iKalyes/ChargingStation3.0/README.md

# ChargingStation3.0
Desktop Charging Station VERSION:3.0 Source Code And UI File Repo.  
桌面充电站-版本：3.0 源代码及UI文件仓库。  
项目发布地址：https://oshwhub.com/ikalyes/duo-xie-yi-zhuo-mian-chong-dian-zhan-3-0   
Copyright ©️ iKalyes 2025  
License - CERN-OHL-P v2  
任何形式的使用、研究、修改、共享和分发硬件设计及基于这些设计的产品请遵守开源协议。
