iKalyes/ChargingStation3.0/前面板图片.png

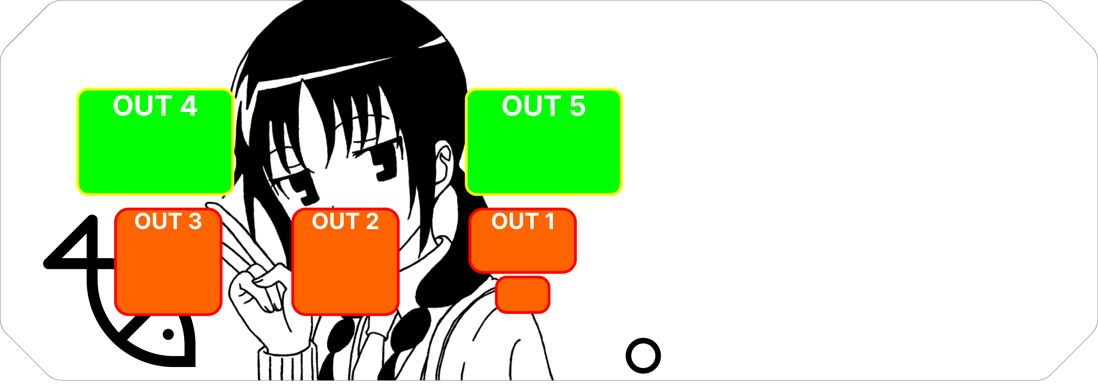
前面板图片.png
