iKalyes/ChargingStation3.0/后面板图片.png

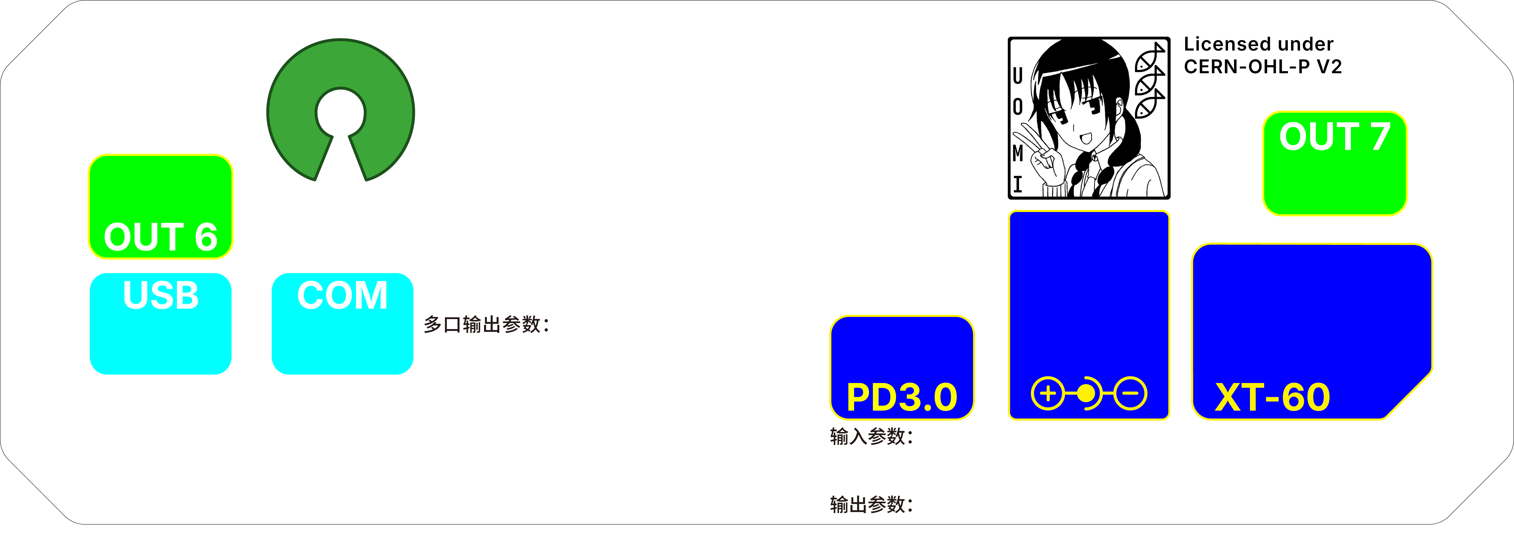
后面板图片.png
