iKalyes/ChargingStation3.0/多协议桌面充电站3.0下层BOM（价格估算）.xlsx

Sheet: bom模板
 |  |  |  | 多协议桌面充电站3.0下层BOM
 |  |  |  | Project Title：多协议桌面充电站3.0
 |  |  |  | Update Time: 2025.5.6
No. | 数量 | 名称 | 位号 | 封装 | 数值或注释 | 料号或注释 | 厂商 | 供应商 | 总价（数量） | 总价 | Check
1 | 4 | 5mΩ | R21, R22, R34, R35 | R2512 | 5mΩ | RLM25FEER005 | 大毅科技 | C185817 | 2.82(10) | 2.82
2 | 4 | 10mΩ | R19, R32, R45, R46 | RES-SMD_L6.4-W3.2-R2512 | 10mΩ | FMF25JPKR010-LH | PSA(信昌电陶) | C5144767 | 上层已计算 | 0
3 | 2 | 20mΩ | R17, R72 | RES-SMD_L6.4-W3.2_LR2512D-3W-1MR | 20mΩ | HoYLR2512-3W-20mR-1% | Milliohm(毫欧) | C5375467 | 3.16(10) | 3.16
4 | 11 | 2Ω | R25, R26, R27, R28, R29, R38, R39, R40, R41, R42, R44 | R0603 | 2Ω | 0603WAF200KT5E | UNI-ROYAL(厚声) | C22977 | 上层已计算 | 0
5 | 15 | 10Ω | R11, R15, R16, R18, R20, R23, R24, R30, R31, R33, R36, R37, R43, R47, R48 | R0603 | 10Ω | 0603WAF100JT5E | UNI-ROYAL(厚声) | C22859 | 0.13(20) | 0.13
6 | 2 | 20Ω | R2, R3 | R0603 | 20Ω | 0603WAF200JT5E | UNI-ROYAL(厚声) | C22950 | 0.69(100) | 0.69
7 | 2 | 1kΩ | R63, R76 | R0603 | 1kΩ | 0603WAF1001T5E | UNI-ROYAL(厚声) | C21190 | 上层已计算 | 0
8 | 11 | 4.7kΩ | R9, R10, R12, R13, R14, R49, R50, R51, R52, R74, R75 | R0603 | 4.7kΩ | 0603WAF4701T5E | UNI-ROYAL(厚声) | C23162 | 0.14(20) | 0.14
9 | 6 | 5.1kΩ | R1, R4, R61, R62, R67, R68 | R0603 | 5.1kΩ | 0603WAF5101T5E | UNI-ROYAL(厚声) | C23186 | 0.66(100) | 0.66
10 | 4 | 10kΩ | R8, R54, R56, R73，R77, R78, R79 | R0603 | 10kΩ | 0603WAF1002T5E | UNI-ROYAL(厚声) | C25804 | 上层已计算 | 0
11 | 1 | 33.2kΩ | R53 | R0603 | 33.2kΩ | FRC0603F3322TS | FOJAN | C2933200 | 0.60(100) | 0.6
12 | 2 | 100kΩ | R5, R57 | R0603 | 100kΩ | 0603WAF1003T5E | UNI-ROYAL(厚声) | C25803 | 上层已计算 | 0
13 | 1 | 200kΩ | R60 | R0603 | 200kΩ | 0603WAF2003T5E | UNI-ROYAL(厚声) | C25811 | 0.70(100) | 0.7
15 | 1 | 1nF | C66 | C0603 | 1nF | CL10B102KB8NNNC | SAMSUNG(三星) | C1588 | 上层已计算 | 0
16 | 4 | 3.3nF | C43, C44, C57, C58 | C0603 | 3.3nF | CL10B332KB8NNNC | SAMSUNG(三星) | C1613 | 3.42(100) | 3.42
17 | 7 | 100nF | C21, C23, C30, C32, C46, C69, C71，C74, C77, C79, C85, C86, C87，C25, C39, C40, C53, C54, C59, C62, C63, C83, C84 | C0603 | 100nF | CL10B104KB8NNNC | SAMSUNG(三星) | C1591 | 上层已计算 | 0
18 | 15 | 1uF | C12, C31, C33, C34, C35, C45, C47, C48, C49，C9, C10, C11, C22, C70, C80 | C0603 | 1uF | CL10A105KB8NNNC | SAMSUNG(三星) | C15849 | 上层已计算 | 0
19 | 5 | 2.2uF | C41, C42, C55, C56, C82 | C0603 | 2.2uF | CL10A225KO8NNNC | SAMSUNG(三星) | C23630 | 3.88(100) | 3.88
20 | 2 | 10uF | C72, C73 | C0805 | 10uF | CL21A106KAYNNNE | SAMSUNG(三星) | C15850 | 1.41(20) | 1.41
21 | 2 | 22uF | C75, C76 | C0805 | 22uF | CL21A226MAQNNNE | SAMSUNG(三星) | C45783 | 1.55(10) | 1.55
22 | 4 | 10uF | C36, C50, C64, C65 | C1206 | 10uF - 耐压35V及以上 | CL31A106KBHNNNE | SAMSUNG(三星) | C13585 | 上层已计算 | 0
23 | 3 | 22uF | C61, C67, C68 | C1206 | 22uF - 耐压25V及以上 | CL31A226KAHNNNE | SAMSUNG(三星) | C12891 | 上层已计算 | 0
24 | 4 | 100uF | C17, C18, C37, C51 | C1210 | 100uF - MLCC | 耐压35V及以上 |  | 淘宝 | 上层已计算 | 0
25 | 5 | 100uF | U10, U12, U14, U16, U19 | CAP-SMD_BD6.3-L6.6-W6.6-LS7.3-FD | 100uF - 固态电容 | 耐压35V及以上 |  | 淘宝 | 上层已计算 | 0
26 | 1 | 220uF | C60 | CAP-SMD_BD8.0-L8.3-W8.3-LS8.9-FD | 220uF - 固态电容 | 耐压35V及以上 |  | 淘宝 | 上层已计算 | 0
27 | 2 | 470uF | U24, U25 | CAP-SMD_BD10.0-L10.3-W10.3-LS11.0-FD | 470uF - 固态电容 | 耐压35V及以上 |  | 淘宝 | 5.3(5) | 5.3
29 | 1 | 2.2uH | L3 | IND-SMD_L4.4-W4.2 | 2.2uH | SLO0420H2R2MTT | Sunltech(韩国顺磁) | C207828 | 4.32(5) | 4.32
30 | 1 | 10uH | L4 | IND-SMD_L11.5-W10.0_FXL1040 | 10uH | FXL1040-100-M | cjiang(长江微电) | C475915 | 上层已计算 | 0
31 | 2 | 10uH | U13, U17 | IND-SMD_L13.8-W12.8 | 10uH | CYA1265-10UH |  | 淘宝 | 7.25(5) | 7.25
32 | 1 | 68uH | L1 | IND-SMD_L7.1-W6.6 | 68uH | SMMS0650-680M | SXN(顺翔诺) | C2894721 | 5.31(5) | 5.31
34 | 1 | ZMM3V3 | D3 | LL-34_L3.5-W1.5-LS3.5-FD |  | ZMM3V3 |  | 上层已计算 | 上层已计算 | 0
35 | 1 | SS24F | D1 | SMAF_L3.5-W2.6-LS4.7-RD |  | SS24F | Hottech(合科泰) | C190803 | 0.71(5) | 0.71
36 | 1 | SMF30A | D4 | SOD-123FL_L2.7-W1.8-LS3.8-RD |  | SMF30A | 宏迦橙 | C19077518 | 3.01(20) | 3.01
37 | 1 | SS26 | D2 | SMA_L4.4-W2.8-LS5.4-RD |  | SS26 | BORN(伯恩半导体) | C306851 | 2.68(10) | 2.68
39 | 2 | S8050 J3Y | Q13, Q14 | SOT-23-3_L3.0-W1.7-P0.95-LS2.9-BR |  | S8050 J3Y | CJ(江苏长电/长晶) | C2146 | 4.34(50) | 4.34
40 | 1 | 2N7002 | Q22 | SOT-23-3_L2.9-W1.3-P1.90-LS2.4-BR |  | 2N7002 | CJ(江苏长电/长晶) | C8545 | 上层已计算 | 0
41 | 3 | DTC143ZCA | Q2, Q3, Q16 | SOT-23-3_L2.9-W1.3-P1.90-LS2.4-BR |  | DTC143ZCA | CJ(江苏长电/长晶) | C15236 | 上层已计算 | 0
42 | 2 | NCE30P30K | Q1, Q15 | TO-252-2_L6.6-W6.1-P4.57-LS9.9-TL-CW |  | NCE30P30K | NCE(无锡新洁能) | C130106 | 上层已计算 | 0
43 | 10 | AP75N03NF | Q4, Q5, Q6, Q7, Q8, Q9, Q10, Q11, Q12, Q21 | PDFN-8_L5.8-W4.9-P1.27-LS6.1-BL | 参数更好或相同均可 | AP75N03NF | APM | 淘宝 | 6(10) | 6
45 | 1 | LMV321-TR | U8 | SOT-23-5_L3.0-W1.7-P0.95-LS2.8-BR |  | LMV321-TR | Gainsil(聚洵) | C362273 | 上层已计算 | 0
46 | 1 | CH221K | Q20 | SOT-23-6_L2.9-W1.6-P0.95-LS2.8-BL-2 |  | CH221K |  | 淘宝 | 7.00(5) | 7
47 | 1 | XL1509-5.0E1 | U4 | SOIC-8_L5.0-W4.0-P1.27-LS6.0-BL |  | XL1509-5.0E1 | XLSEMI(芯龙) | C61063 | 7.65(5) | 7.65
48 | 1 | MX74610T | U26 | SOT-23-6_L2.9-W1.6-P0.95-LS2.8-BL-1 |  | MX74610T |  | 淘宝 | 6.8(5) | 6.8
49 | 1 | INA219AIDCNR | U6 | SOT-23-8_L3.0-W1.7-P0.65-LS2.8-BR |  | INA219AIDCNR | TI(德州仪器) | C87469 | 4.54(1) | 4.54
50 | 1 | CH340K | U21 | ESOP-10_L4.9-W3.9-P1.00-LS6.2-BL-EP |  | CH340K | WCH(南京沁恒) | C968586 | 4.11(1) | 4.11
51 | 1 | INA3221AIRGVR | U7 | QFN-16_L4.0-W4.0-P0.65-TL-EP2.2 |  | INA3221AIRGVR | TI(德州仪器) | C181255 | 6.5(1) | 6.5
52 | 2 | IP6557_C | U11, U15 | QFN-40_L5.0-W5.0-P0.40-BL-EP3.7 |  | IP6557_C |  | 淘宝 | 13(2) | 13
53 | 1 | TPS563201DDCR | U22 | SOT-23-6_L2.9-W1.6-P0.95-LS2.8-BL |  | TPS563201DDCR | TI(德州仪器) | C116592 | 2.58(5) | 2.58
54 | 1 | IP6538-AC | U18 | QFN-32_L5.0-W5.0-P0.50-TL-EP3.4 |  | IP6538-AC | INJOINIC(英集芯) | 淘宝 | 4(1) | 4
55 | 1 | ESP32-S3-WROOM-1-N8R2 | U20 | WIRELM-SMD_ESP32-S3-WROOM-1 | FLASH大于等于8MB均可 | ESP32-S3-WROOM-1-N8R2 |  | 淘宝 | 14.8(1) | 14.8
57 | 2 | TSA002A3512A02 | SW1, SW2 | SW-SMD_BZCN_TSA002A35XXX |  | TSA002A3512A02 | BZCN(博众电气) | C2888932 | 2.35(20) | 2.35
58 | 2 | ZX-XH2.54-2PLT | U27, U29 | CONN-SMD_2P-P2.50_HCTL_HC-XH-2ALT |  | ZX-XH2.54-2PLT | Megastar(兆星) | C7429680 | 上层已计算 | 0
59 | 2 | 0451010.MRL | U2, U3 | FUSE-SMD_L6.1-W2.7 |  | 0451010.MRL | Littelfuse(美国力特) | C44479 | 3.47(5) | 3.47
60 | 1 | AFC07-S12ECA-00 | FPC2 | FPC-SMD_12P-P0.50_AFC07-S12ECA-00 | 12Pin 0.5mm 上接 | AFC07-S12ECA-00 | JS(钜硕电子) | C262585 | 3.53(5) | 3.53
61 | 1 | AFA07-S12FCA-00 | FPC1 | FPC-SMD_P1.00-12P_LCS-XJ-H2.5 |  | AFA07-S12FCA-00 | JS(钜硕电子) | C262718 | 上层已计算 | 0
62 | 3 | XL-4020RGBC-WS2812B | LED1, LED2, LED3 | LED-SMD_4P-L4.0-W1.7_XL-4020RGBC-WS2812B |  | XL-4020RGBC-WS2812B | XINGLIGHT(成兴光) | C3647024 | 3.91(5) | 3.91
63 | 1 | LY-K3-01B-04 | U28 | SW-SMD_QS-301-AGS5P |  | LY-K3-01B-04 | 温州一键（淘宝） | 淘宝 | 6.4(10) | 6.4
64 | 5 | U262-161N-4BVC11 | USB1, USB2, USB3, USB4,USB5, USB6 | USB-3.1-SMD_U262-161N-4BVC11 |  |  | 汉德电子连接器（淘宝） | 淘宝 | 上层已计算 | 0
65 | 1 | DC007B-2.5-J | U30 | DC-IN-TH_HX-DC007B-2.5 | 5525和5521均可 | DC007B-2.5-J | SHOU HAN(首韩) | C17701686 | 2.67(1) | 2.67
66 | 1 | XT60PW-M | CN1 | CONN-TH_XT60PW-M |  | XT60PW-M | AMASS(艾迈斯) | C98732 | 3.79(1) | 3.79
67 | 1 | 1.3寸LCD液晶屏幕（ST7789） | 12PIN 插接 |  |  |  |  | 淘宝 | 5.4(1) | 5.4
68 | 1 | 铝型材外壳 | 104*36*80（毫米） |  | 嘉立创定制铝型材外壳 | 阳极氧化+UV打印 |  | 嘉立创 | 101.9(2) | 101.9
69 | 1 | NTC100K B3950 |  |  |  |  |  | 淘宝 | 1.31（1） | 1.31
 |  |  |  |  |  |  |  |  |  | 263.79

Sheet: Field汇总
Project Title | 多协议桌面充电站3.0
Borard Title | 下层
Schematic Title | 下层
PCB Title
Variant Name
Total Quantity | 198
Report Time | 22:22:33
Report Date | 2025年4月6日
Report Date&Time | 2025年4月6日 22:22:33
File Name | BOM_下层_下层_2025-04-06
Filter Option | Add into BOM:no;
