iKalyes/ChargingStation3.0/多协议桌面充电站3.0上层BOM（价格估算）.xlsx

Sheet: bom模板
 |  |  |  | 多协议桌面充电站3.0上层BOM
 |  |  |  | Project Title：多协议桌面充电站3.0
No. | Quantity | Comment | Designator | Footprint | Value | Manufacturer Part | Manufacturer | Supplier Part
1 | 4 | AP75N03NF | Q1, Q4, Q6, Q7 | PDFN-8_L5.8-W4.9-P1.27-LS6.1-BL |  | AP75N03NF | APM | 淘宝 | 2.4(4) | 2.4
2 | 4 | 10kΩ | R8, R16, R17, R18, R12 | R0603 | 10kΩ | 0603WAF1002T5E | UNI-ROYAL(厚声) | C25804 | 0.63(100) | 0.63
3 | 1 | 100kΩ | R6 | R0603 | 100kΩ | 0603WAF1003T5E | UNI-ROYAL(厚声) | C25803 | 0.26(50) | 0.26
4 | 3 | 1kΩ | R7, R11, R19 | R0603 | 1kΩ | 0603WAF1001T5E | UNI-ROYAL(厚声) | C21190 | 0.65(100) | 0.65
5 | 2 | 2Ω | R1, R20 | R0603 | 2Ω | 0603WAF200KT5E | UNI-ROYAL(厚声) | C22977 | 1(100) | 1
6 | 14 | 100nF | C7, C8, C10, C12, C16, C18, C36, C38, C39, C40, C47, C49, C51, C56 | C0603 | 100nF | CC0603KRX7R9BB104 | YAGEO(国巨) | C14663 | 1.56(100) | 1.56
7 | 2 | 1nF | C1, C41 | C0603 | 1nF | CL10B102KB8NNNC | SAMSUNG(三星) | C1588 | 1.93(100) | 1.93
8 | 2 | 1uF | C35, C37 | C0603 | 1uF | CL10A105KB8NNNC | SAMSUNG(三星) | C15849 | 1.68(50) | 1.68
9 | 4 | 10uF | C2, C3, C42, C43 | C1206 | 10uF 耐压35V及以上 | CL31A106KBHNNNE | SAMSUNG(三星) | C13585 | 2.24(10) | 2.24
10 | 10 | 22uF | C5, C6, C14, C15, C17, C45, C46, C48, C50, C57 | C1206 | 22uF 耐压25V及以上 | CL31A226KAHNNNE | SAMSUNG(三星) | C12891 | 6.99(20) | 6.99
11 | 8 | 100uF | C19, C20, C21, C22, C52, C53, C54, C55 | C1210 | 100uF | 耐压35V及以上 |  | 淘宝 | 4.2(15) | 4.2
12 | 2 | 100uF | U2, U10 | CAP-SMD_BD6.3-L6.6-W6.6-LS7.3-FD | 100uF - 固态电容 | 耐压35V及以上 |  | 淘宝 | 6.9(15) | 6.9
13 | 2 | 220uF | C4, C44 | CAP-SMD_BD8.0-L8.3-W8.3-LS8.9-FD | 220uF - 固态电容 | 耐压35V及以上 |  | 淘宝 | 10.35(15) | 10.35
14 | 1 | ZMM3V3 | D3 | LL-34_L3.5-W1.5-LS3.5-FD |  | ZMM3V3 | 萨科微(Slkor) | C707189 | 3.03(50) | 3.03
15 | 1 | 2N7002 | Q5 | SOT-23-3_L2.9-W1.3-P1.90-LS2.4-BR |  | 2N7002 | CJ(江苏长电/长晶) | C8545 | 4.71(50 | 4.71
16 | 1 | DTC143ZCA | Q3 | SOT-23-3_L2.9-W1.3-P1.90-LS2.4-BR |  | DTC143ZCA | CJ(江苏长电/长晶) | C15236 | 2.34(20) | 2.34
17 | 1 | ME6212C33M5G | U3 | SOT-23-5_L3.0-W1.7-P0.95-LS2.8-BL |  | ME6212C33M5G | MICRONE(南京微盟) | C81233 | 2.36(10) | 2.36
18 | 4 | 10mΩ | R2, R10, R21, R22 | RES-SMD_L6.4-W3.2-R2512 | 10mΩ | FMF25JPKR010-LH | PSA(信昌电陶) | C5144767 | 3.15(10) | 3.15
19 | 2 | LMV321-TR | U8, U9 | SOT-23-5_L3.0-W1.7-P0.95-LS2.8-BR |  | LMV321-TR | Gainsil(聚洵) | C362273 | 10(4.17) | 10
20 | 1 | ZX-XH2.54-2PLT | U29 | CONN-SMD_2P-P2.50_HCTL_HC-XH-2ALT |  | ZX-XH2.54-2PLT | Megastar(兆星) | C7429680 | 1.89(5) | 1.89
21 | 1 | AFA07-S12FCA-00 | FPC1 | FPC-SMD_P1.00-12P_LCS-XJ-H2.5 |  | AFA07-S12FCA-00 | JS(钜硕电子) | C262718 | 3.73(5) | 3.73
22 | 1 | NCE30P30K | Q2 | TO-252-2_L6.6-W6.1-P4.57-LS9.9-TL-CW |  | NCE30P30K | NCE(无锡新洁能) | C130106 | 6.83(5) | 6.83
23 | 2 | 919-152A1072D10400 | USB1, USB3 | USB-A-TH_919-152A1072D10400 |  | 前脚卧插 | 汉德电子连接器 | 淘宝 | 2.8(10) | 2.8
24 | 2 | 10uH | L1, L2 | IND-SMD_L11.5-W10.0_FXL1040 | 10uH | FXL1040-100-M | cjiang(长江微电) | C475915 | 6.43(5) | 6.43
25 | 2 | U262-161N-4BVC11 | USB2, USB4 | USB-3.1-SMD_U262-161N-4BVC11 |  |  | 汉德电子连接器 | 淘宝 | 6.7(10) | 6.7
26 | 2 | IP6538-AC | U4, U11 | QFN-32_L5.0-W5.0-P0.50-TL-EP3.4 |  | IP6538-AC | INJOINIC(英集芯) | C669696 | 8(2) | 8
27 | 1 | FPC 排线 |  |  | 12PIN 1.0MM 6CM 同向 |  |  | 淘宝 | 0.9(5) | 0.9
28 |  |  |  |  |  |  |  |  |  | 103.66

Sheet: Field汇总
Project Title | 多协议桌面充电站3.0
Borard Title | 上层
Schematic Title | 上层
PCB Title
Variant Name
Total Quantity | 80
Report Time | 21:50:17
Report Date | 2025年4月6日
Report Date&Time | 2025年4月6日 21:50:17
File Name | BOM_上层_上层_2025-04-06
Filter Option | Add into BOM:no;
