iKalyes/ChargingStation3.0/前面板开孔.dxf

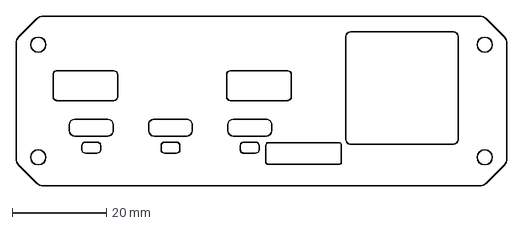
[picture p14: CAD file, 2025-04-26]
前面板开孔.dxf
104.0 x 36.0 mm
