iKalyes/ChargingStation3.0/后面板开孔.dxf

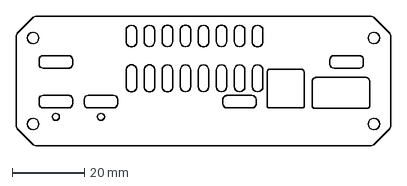
[picture p15: CAD file, 2025-04-26]
后面板开孔.dxf
104.0 x 36.0 mm
