iKalyes/ChargingStation3.0/src/display.cpp

#include <display.h>

TFT_eSPI tft = TFT_eSPI(screenWidth, screenHeight); /* TFT instance */

void my_disp_flush( lv_disp_drv_t *disp_drv, const lv_area_t *area, lv_color_t *color_p )
{
    uint32_t w = ( area->x2 - area->x1 + 1 );
    uint32_t h = ( area->y2 - area->y1 + 1 );

    tft.startWrite();
    tft.setAddrWindow( area->x1, area->y1, w, h );
    tft.pushColors( ( uint16_t * )&color_p->full, w * h, true );
    tft.endWrite();

    lv_disp_flush_ready( disp_drv );
}

void backlight_init()
{
    ledcSetup(0, 1000, 8);
    ledcAttachPin(TFT_BL, 0); //backlight control
    ledcWrite(0, brightness);
}

void backlight_set( uint8_t brightness )
{
    ledcWrite(0, brightness);
}

void display_init()
{
    lv_init();

    tft.begin();          /* TFT init */
    tft.fillScreen( TFT_BLACK ); /* Fill the screen with black */
    tft.setRotation( rotation ); /* Landscape orientation, flipped */

    lv_disp_draw_buf_init( &draw_buf, buf, NULL, screenWidth * 10 );

    /*Initialize the display*/
    static lv_disp_drv_t disp_drv;
    lv_disp_drv_init( &disp_drv );
    /*Change the following line to your display resolution*/
    disp_drv.hor_res = screenWidth;
    disp_drv.ver_res = screenHeight;
    disp_drv.flush_cb = my_disp_flush;
    disp_drv.draw_buf = &draw_buf;
    lv_disp_drv_register( &disp_drv );
    
    ui_init(); /* Initialize the UI */

    setting_reset();
    backlight_init(); /* Initialize the backlight */
    style_reset(); /* Initialize the focus style */
}

void display_task()
{
    lv_task_handler(); /* let the GUI do its work */
}

void display_set_rotation( uint8_t new_rotation )
{
    rotation = new_rotation;
    tft.setRotation( rotation ); /* Set the new rotation */
    lv_disp_set_rotation( lv_disp_get_default(), ( lv_disp_rot_t )rotation ); /* Update LVGL display rotation */
}

void style_reset()
{
    lv_obj_set_style_outline_color(ui_USBC32Switch, lv_color_hex(0xffff00), LV_STATE_FOCUS_KEY);
    lv_obj_set_style_outline_color(ui_USBC1Switch, lv_color_hex(0xffff00), LV_STATE_FOCUS_KEY);
    lv_obj_set_style_outline_color(ui_USBASwitch, lv_color_hex(0xffff00), LV_STATE_FOCUS_KEY);
    lv_obj_set_style_outline_color(ui_Setting, lv_color_hex(0xffffff), LV_STATE_FOCUS_KEY);
    lv_obj_set_style_outline_color(ui_Weather, lv_color_hex(0xffffff), LV_STATE_FOCUS_KEY);
    
    lv_obj_set_style_outline_color(ui_WiFiWebPage, lv_color_hex(0xffffff), LV_STATE_FOCUS_KEY);
    lv_obj_set_style_outline_color(ui_AdvancedSetting, lv_color_hex(0xffffff), LV_STATE_FOCUS_KEY);
    lv_obj_set_style_outline_color(ui_FanSwitch, lv_color_hex(0xffffff), LV_STATE_FOCUS_KEY);
    lv_obj_set_style_outline_color(ui_RotationPlus, lv_color_hex(0xffffff), LV_STATE_FOCUS_KEY);
    lv_obj_set_style_outline_color(ui_RotationMinus, lv_color_hex(0xffffff), LV_STATE_FOCUS_KEY);
    lv_obj_set_style_outline_color(ui_SliderBrightness, lv_color_hex(0xffffff), LV_STATE_FOCUS_KEY);
    lv_obj_set_style_outline_color(ui_SliderBrightness, lv_color_hex(0xffff00), LV_STATE_EDITED);
    lv_obj_set_style_outline_color(ui_Back, lv_color_hex(0xffffff), LV_STATE_FOCUS_KEY);

    lv_obj_set_style_outline_color(ui_USBA1Adjust, lv_color_hex(0xffffff), LV_STATE_FOCUS_KEY);
    lv_obj_set_style_outline_color(ui_USBA1Adjust, lv_color_hex(0xffff00), LV_STATE_EDITED);
    lv_obj_set_style_outline_color(ui_USBA2Adjust, lv_color_hex(0xffffff), LV_STATE_FOCUS_KEY);
    lv_obj_set_style_outline_color(ui_USBA2Adjust, lv_color_hex(0xffff00), LV_STATE_EDITED);
    lv_obj_set_style_outline_color(ui_ThermometerAdjust, lv_color_hex(0xffffff), LV_STATE_FOCUS_KEY);
    lv_obj_set_style_outline_color(ui_ThermometerAdjust, lv_color_hex(0xffff00), LV_STATE_EDITED);
    lv_obj_set_style_outline_color(ui_ThermometerControl, lv_color_hex(0xffffff), LV_STATE_FOCUS_KEY);
    lv_obj_set_style_outline_color(ui_LEDControl, lv_color_hex(0xffffff), LV_STATE_FOCUS_KEY);
    lv_obj_set_style_outline_color(ui_SyncTimeAdjust, lv_color_hex(0xffffff), LV_STATE_FOCUS_KEY);
    lv_obj_set_style_outline_color(ui_SyncTimeAdjust, lv_color_hex(0xffff00), LV_STATE_EDITED);
    lv_obj_set_style_outline_color(ui_AdvancedSettingBack, lv_color_hex(0xffffff), LV_STATE_FOCUS_KEY);

    lv_obj_set_style_outline_color(ui_WIFIStart, lv_color_hex(0xffffff), LV_STATE_FOCUS_KEY);
    lv_obj_set_style_outline_color(ui_WIFIReset, lv_color_hex(0xffffff), LV_STATE_FOCUS_KEY);
    lv_obj_set_style_outline_color(ui_WIFIBack, lv_color_hex(0xffffff), LV_STATE_FOCUS_KEY);

    lv_obj_set_style_outline_color(ui_WeatherBack, lv_color_hex(0xffffff), LV_STATE_FOCUS_KEY);
    lv_obj_set_style_outline_color(ui_WeatherSetting, lv_color_hex(0xffffff), LV_STATE_FOCUS_KEY);

    static lv_style_t style_pr;
    lv_style_init(&style_pr);
    lv_style_set_transform_width(&style_pr, 0);
    lv_style_set_transform_height(&style_pr, 0);
    lv_obj_add_style(ui_Weather, &style_pr, LV_STATE_PRESSED);
    lv_obj_add_style(ui_Setting, &style_pr, LV_STATE_PRESSED);
    lv_obj_add_style(ui_WiFiWebPage, &style_pr, LV_STATE_PRESSED);
    lv_obj_add_style(ui_AdvancedSetting, &style_pr, LV_STATE_PRESSED);
    lv_obj_add_style(ui_Back, &style_pr, LV_STATE_PRESSED);
    lv_obj_add_style(ui_AdvancedSettingBack, &style_pr, LV_STATE_PRESSED);
    lv_obj_add_style(ui_WIFIBack, &style_pr, LV_STATE_PRESSED);
    lv_obj_add_style(ui_WIFIStart, &style_pr, LV_STATE_PRESSED);
    lv_obj_add_style(ui_WIFIReset, &style_pr, LV_STATE_PRESSED);
    lv_obj_add_style(ui_WeatherBack, &style_pr, LV_STATE_PRESSED);
    lv_obj_add_style(ui_WeatherSetting, &style_pr, LV_STATE_PRESSED);
}

void setting_reset()
{
    lv_label_set_text_fmt(ui_FreeSpace, "ROM:%dB", free_space);

    if(USBC32_Switch == true)
    {
        lv_obj_add_state(ui_USBC32Switch, LV_STATE_CHECKED);
        USBC32_ON();
    }
    else
    {
        lv_obj_clear_state(ui_USBC32Switch, LV_STATE_CHECKED);
        USBC32_OFF();
    }
    if(USBC1_Switch == true)
    {
        lv_obj_add_state(ui_USBC1Switch, LV_STATE_CHECKED);
        USBC1_ON();
    }
    else
    {
        lv_obj_clear_state(ui_USBC1Switch, LV_STATE_CHECKED);
        USBC1_OFF();
    }
    if(USBA_Switch == true)
    {
        lv_obj_add_state(ui_USBASwitch, LV_STATE_CHECKED);
        USBA_ON();
    }
    else
    {
        lv_obj_clear_state(ui_USBASwitch, LV_STATE_CHECKED);
        USBA_OFF();
    }

    lv_slider_set_value(ui_SliderBrightness, (uint8_t)(brightness / 2.55f + 0.5f), LV_ANIM_OFF);
    lv_label_set_text_fmt(ui_Brightness, "%d%%", (uint8_t)(brightness / 2.55f + 0.5f));
    int value_full = round(SyncTime * 10);
    int value_int = value_full / 10;
    int value_frac = value_full % 10;
    lv_label_set_text_fmt(ui_TextSyncTimeAdjust, "%d.%d小时", value_int, value_frac);
    if(fan_switch == true)
    {
        lv_obj_add_state(ui_FanSwitch, LV_STATE_CHECKED);
        FAN_ON();
    }
    else
    {
        lv_obj_clear_state(ui_FanSwitch, LV_STATE_CHECKED);
        FAN_OFF();
    }
    if(tempcontrol_fan == true)
    {
        lv_obj_add_state(ui_ThermometerControl, LV_STATE_CHECKED);
    }
    else
    {
        lv_obj_clear_state(ui_ThermometerControl, LV_STATE_CHECKED);
    }
    if(led_enabled == true)
    {
        lv_obj_add_state(ui_LEDControl, LV_STATE_CHECKED);
    }
    else
    {
        lv_obj_clear_state(ui_LEDControl, LV_STATE_CHECKED);
    }
    lv_slider_set_value(ui_USBA1Adjust, (uint16_t)(voltage0_adc * 100), LV_ANIM_OFF);
    lv_slider_set_value(ui_USBA2Adjust, (uint16_t)(voltage1_adc * 100), LV_ANIM_OFF);
    lv_slider_set_value(ui_ThermometerAdjust, (uint16_t)(temperature_adc * 100), LV_ANIM_OFF);
}
