iKalyes/ChargingStation3.0/src/lvgl_event.cpp

#include <lvgl_event.h>

void ui_event_USBC32Switch( lv_event_t * e) {
    lv_event_code_t event_code = lv_event_get_code(e);lv_obj_t * target = lv_event_get_target(e);

if ( event_code == LV_EVENT_VALUE_CHANGED &&  lv_obj_has_state(target,LV_STATE_CHECKED)  ) {
      USBC32PON( e );
      USBC32_ON();
      setSwitch("typeC32", true);
      save_USBC_setting();
}
if ( event_code == LV_EVENT_VALUE_CHANGED &&  !lv_obj_has_state(target,LV_STATE_CHECKED)  ) {
      USBC32POFF( e );
      USBC32_OFF();
      setSwitch("typeC32", false);
      save_USBC_setting();
}
}

void ui_event_USBC1Switch( lv_event_t * e) {
    lv_event_code_t event_code = lv_event_get_code(e);lv_obj_t * target = lv_event_get_target(e);

if ( event_code == LV_EVENT_VALUE_CHANGED &&  lv_obj_has_state(target,LV_STATE_CHECKED)  ) {
      USBC1PON( e );
      USBC1_ON();
      setSwitch("typeC1", true);
      save_USBC_setting();
}
if ( event_code == LV_EVENT_VALUE_CHANGED &&  !lv_obj_has_state(target,LV_STATE_CHECKED)  ) {
      USBC1POFF( e );
      USBC1_OFF();
      setSwitch("typeC31", false);
      save_USBC_setting();     
}
}

void ui_event_USBASwitch( lv_event_t * e) {
    lv_event_code_t event_code = lv_event_get_code(e);lv_obj_t * target = lv_event_get_target(e);

if ( event_code == LV_EVENT_VALUE_CHANGED &&  lv_obj_has_state(target,LV_STATE_CHECKED)  ) {
      USBA45ON( e );
      USBA_ON();
      setSwitch("usbA", true);
      save_USBA_setting();
}
if ( event_code == LV_EVENT_VALUE_CHANGED &&  !lv_obj_has_state(target,LV_STATE_CHECKED)  ) {
      USBA45OFF( e );
      USBA_OFF();
      setSwitch("usbA", false);
      save_USBA_setting();
}
}

void ui_event_Weather( lv_event_t * e) {
    lv_event_code_t event_code = lv_event_get_code(e);

if ( event_code == LV_EVENT_RELEASED) {
      _ui_screen_change( &ui_WeatherScreen, LV_SCR_LOAD_ANIM_FADE_ON, 100, 0, &ui_WeatherScreen_screen_init);
      lvgl_group_to_weather();
}
}

void ui_event_Setting( lv_event_t * e) {
    lv_event_code_t event_code = lv_event_get_code(e);

if ( event_code == LV_EVENT_RELEASED) {
      _ui_screen_change( &ui_SettingScreen, LV_SCR_LOAD_ANIM_FADE_ON, 200, 0, &ui_SettingScreen_screen_init);
      lvgl_group_to_setting();
}
}

void ui_event_WiFiWebPage(lv_event_t * e)
{
    lv_event_code_t event_code = lv_event_get_code(e);

    if(event_code == LV_EVENT_RELEASED) {
        _ui_screen_change(&ui_WiFiScreen, LV_SCR_LOAD_ANIM_NONE, 0, 0, &ui_WiFiScreen_screen_init);
        lvgl_group_to_wifi();
    }
}

void ui_event_AdvancedSetting( lv_event_t * e) {
    lv_event_code_t event_code = lv_event_get_code(e);

if ( event_code == LV_EVENT_RELEASED) {
      _ui_screen_change( &ui_AdvancedSettingScreen, LV_SCR_LOAD_ANIM_FADE_ON, 100, 0, &ui_AdvancedSettingScreen_screen_init);
      lvgl_group_to_advancedsetting();
}
}

void ui_event_FanSwitch( lv_event_t * e) {
    lv_event_code_t event_code = lv_event_get_code(e);lv_obj_t * target = lv_event_get_target(e);

if ( event_code == LV_EVENT_VALUE_CHANGED &&  lv_obj_has_state(target,LV_STATE_CHECKED)  ) {
      FanSwitchON( e );
      FAN_ON();
      setSwitch("fan", true);
}
if ( event_code == LV_EVENT_VALUE_CHANGED &&  !lv_obj_has_state(target,LV_STATE_CHECKED)  ) {
      FanSwitchOFF( e );
      FAN_OFF();
      setSwitch("fan", false);
}
}

void ui_event_RotationPlus(lv_event_t * e)
{
    lv_event_code_t event_code = lv_event_get_code(e);

    if(event_code == LV_EVENT_RELEASED) {
        RotationPlus(e);
        // 增加旋转角度，范围0-4循环
        rotation = (rotation + 1) % 5;
        display_set_rotation(rotation);
    }
}

void ui_event_RotationMinus(lv_event_t * e)
{
    lv_event_code_t event_code = lv_event_get_code(e);

    if(event_code == LV_EVENT_RELEASED) {
        RotationMinus(e);
        // 减少旋转角度，范围0-4循环
        rotation = (rotation == 0) ? 4 : (rotation - 1);
        display_set_rotation(rotation);
    }
}

void ui_event_SliderBrightness( lv_event_t * e) {
    lv_event_code_t event_code = lv_event_get_code(e);lv_obj_t * target = lv_event_get_target(e);

if ( event_code == LV_EVENT_VALUE_CHANGED) {
      _ui_slider_set_text_value( ui_Brightness, target, "", "%");
      int slider_value = lv_slider_get_value(target);
      brightness = (uint8_t)(slider_value * 2.55f + 0.5f); // 加0.5是为了四舍五入
      backlight_set(brightness);
}
}

void ui_event_Back( lv_event_t * e) {
    lv_event_code_t event_code = lv_event_get_code(e);

if ( event_code == LV_EVENT_RELEASED) {
      _ui_screen_change( &ui_MainScreen, LV_SCR_LOAD_ANIM_FADE_ON, 200, 0, &ui_MainScreen_screen_init);
      lvgl_group_to_main();
      save_setting();
}
}

void ui_event_USBA1Adjust(lv_event_t * e) {
    lv_event_code_t event_code = lv_event_get_code(e);

    if(event_code == LV_EVENT_VALUE_CHANGED) {
        USBA1Adjust(e);
        voltage0_adc = (float)(lv_slider_get_value(ui_USBA1Adjust)) * 0.01f;
    }
}

void ui_event_USBA2Adjust( lv_event_t * e) {
    lv_event_code_t event_code = lv_event_get_code(e);

if ( event_code == LV_EVENT_VALUE_CHANGED) {
      USBA2Adjust( e );
      voltage1_adc = (float)(lv_slider_get_value(ui_USBA2Adjust)) * 0.01f;
}
}

void ui_event_ThermometerAdjust( lv_event_t * e) {
    lv_event_code_t event_code = lv_event_get_code(e);

if ( event_code == LV_EVENT_VALUE_CHANGED) {
      TempAdjust( e );
      temperature_adc = (float)(lv_slider_get_value(ui_ThermometerAdjust)) * 0.01f;
}
}

void ui_event_ThermometerControl( lv_event_t * e) {
    lv_event_code_t event_code = lv_event_get_code(e);lv_obj_t * target = lv_event_get_target(e);

if ( event_code == LV_EVENT_VALUE_CHANGED &&  lv_obj_has_state(target,LV_STATE_CHECKED)  ) {
      TempControlON( e );
      tempcontrol_fan = true;
      setSwitch("fanTemp", true);
}
if ( event_code == LV_EVENT_VALUE_CHANGED &&  !lv_obj_has_state(target,LV_STATE_CHECKED)  ) {
      TempControlOFF( e );
      tempcontrol_fan = false;
      setSwitch("fanTemp", false);
}
}

void ui_event_LEDControl( lv_event_t * e) {
    lv_event_code_t event_code = lv_event_get_code(e);lv_obj_t * target = lv_event_get_target(e);

if ( event_code == LV_EVENT_VALUE_CHANGED &&  lv_obj_has_state(target,LV_STATE_CHECKED)  ) {
      LEDControlON( e );
      led_enabled = true;
      setSwitch("chargeLed", true);
}
if ( event_code == LV_EVENT_VALUE_CHANGED &&  !lv_obj_has_state(target,LV_STATE_CHECKED)  ) {
      LEDControlOFF( e );
      led_enabled = false;
      setSwitch("chargeLed", false);
}
}

void ui_event_SyncTimeAdjust( lv_event_t * e) {
    lv_event_code_t event_code = lv_event_get_code(e);lv_obj_t * target = lv_event_get_target(e);

if ( event_code == LV_EVENT_VALUE_CHANGED) {
    float value = lv_slider_get_value(target) / 10.0f;
    int value_full = round(value * 10);
    int value_int = value_full / 10;
    int value_frac = value_full % 10;
    lv_label_set_text_fmt(ui_TextSyncTimeAdjust, "%d.%d小时", value_int, value_frac);
    SyncTime = value;
    time_server_setsynctime(SyncTime);
}
}

void ui_event_AdvancedSettingBack( lv_event_t * e) {
    lv_event_code_t event_code = lv_event_get_code(e);

if ( event_code == LV_EVENT_RELEASED) {
      _ui_screen_change( &ui_SettingScreen, LV_SCR_LOAD_ANIM_FADE_ON, 100, 0, &ui_SettingScreen_screen_init);
      lvgl_group_to_setting();
      save_advanced_setting();
}
}

void ui_event_WIFIStart(lv_event_t * e)
{
    lv_event_code_t event_code = lv_event_get_code(e);

    if(event_code == LV_EVENT_RELEASED) {
        WIFIStart(e);
        wificonfig_flag = true;
    }
}

void ui_event_WIFIReset(lv_event_t * e)
{
    lv_event_code_t event_code = lv_event_get_code(e);

    if(event_code == LV_EVENT_RELEASED) {
        WIFIResrt(e);
        wifireset();
    }
}

void ui_event_WIFIBack(lv_event_t * e)
{
    lv_event_code_t event_code = lv_event_get_code(e);

    if(event_code == LV_EVENT_RELEASED) {
        _ui_screen_change(&ui_SettingScreen, LV_SCR_LOAD_ANIM_FADE_ON, 200, 0, &ui_SettingScreen_screen_init);
        lvgl_group_to_setting();
    }
}

void ui_event_WeatherBack( lv_event_t * e) {
    lv_event_code_t event_code = lv_event_get_code(e);

if ( event_code == LV_EVENT_RELEASED) {
      _ui_screen_change( &ui_MainScreen, LV_SCR_LOAD_ANIM_FADE_ON, 100, 0, &ui_MainScreen_screen_init);
      lvgl_group_to_main();
}
}

void ui_event_WeatherSetting( lv_event_t * e) {
    lv_event_code_t event_code = lv_event_get_code(e);

if ( event_code == LV_EVENT_RELEASED) {
      _ui_screen_change( &ui_SettingScreen, LV_SCR_LOAD_ANIM_FADE_ON, 100, 0, &ui_SettingScreen_screen_init);
      lvgl_group_to_setting();
}
}
