iKalyes/ChargingStation3.0/src/main.h

#ifndef _MAIN_H
#define _MAIN_H

#define ENABLE_DEBUG 1

#include <Arduino.h>

#include <display.h>
#include <ina219.h>
#include <ina3221_service.h>
#include <key.h>
#include <adc.h>
#include <lvgl_group.h>
#include <lvgl_event.h>
#include <variables.h>
#include <flash.h>
#include <gpio.h>
#include <wifi_service.h>
#include <main_service.h>
#include <rgbled.h>
#include <web_server.h>

#endif
