iKalyes/ChargingStation3.0/src/variables.cpp

#include <variables.h>

//ADVANCED SETTING//
float voltage0_adc = 10.85f;
float voltage1_adc = 10.85f;
float temperature_adc = 0.1f;
bool tempcontrol_fan = false; //温控风扇开关
// 全局变量控制所有LED灯的开关状态
bool led_enabled = false;
//SEETING SCREEN//
uint8_t brightness = 0;
uint8_t rotation = 0;
bool fan_switch = false;
uint8_t free_space;
//MAIN SCREEN//
bool USBC32_Switch = false;
bool USBC1_Switch = false;
bool USBA_Switch = false;
//FOR WEB AND WEATHER//
uint16_t UpdateWeater_Time = 10; //10分钟更新
String CityCode = "101280101"; //广州
String qWeather_ApiHost = "";
String qWeather_Key = "";
uint8_t TimeZone = 8;
float SyncTime = 1;
String NTPServer = "pool.ntp.org";
config_type wifisetting ={{""},{""}};
bool wificonfig_flag = false;
