iKalyes/ChargingStation3.0/src/variables.h

#ifndef _VARIABLES_H
#define _VARIABLES_H

#include <Arduino.h>
#include <lvgl.h>
//ADVANCED SETTING//
extern float voltage0_adc;
extern float voltage1_adc;
extern float temperature_adc;
extern bool tempcontrol_fan;
extern bool led_enabled; //全局变量控制所有LED灯的开关状态
//SEETING SCREEN//
extern uint8_t brightness;
extern uint8_t rotation;
extern bool fan_switch;
extern uint8_t free_space;
//MAIN SCREEN//
extern bool USBC32_Switch;
extern bool USBC1_Switch;
extern bool USBA_Switch;
//FOR WEB AND WEATHER//
extern uint16_t UpdateWeater_Time;
extern String CityCode;
extern String qWeather_Key;
extern String qWeather_ApiHost;
extern uint8_t TimeZone;
extern float SyncTime;
extern String NTPServer;
struct config_type
{
    char sta_ssid[32];
    char sta_pwd[64];
};
extern config_type wifisetting;
extern bool wificonfig_flag;

#endif
