iKalyes/ChargingStation3.0/src/lvgl_event.h

#ifndef _LVGL_EVENT_H
#define _LVGL_EVENT_H



#include "ui/ui_helpers.h"
#include "ui/ui_events.h"
#include "ui/ui_theme_manager.h"
#include "ui/ui_themes.h"

#include <Arduino.h>
#include <lvgl.h>
#include <display.h>
#include <variables.h>
#include <lvgl_group.h>
#include <flash.h>
#include <gpio.h>
#include <wifi_service.h>
#include <main_service.h>
#include <web_server.h>



#endif
