iKalyes/ChargingStation3.0/src/flash.h

#ifndef _FLASH_H_
#define _FLASH_H_

#include "ui/ui.h"

#include <Preferences.h>
#include <Arduino.h>
#include <variables.h>
#include <gpio.h>
#include <lvgl.h>

void flash_init();

void get_free_space();
void save_setting();
void load_setting();
void save_USBA_setting();
void save_USBC_setting();
void save_advanced_setting();

void save_web_config();
void load_web_config();
void save_wifi_config();
void load_wifi_config();
void delete_wifi_config();

#endif
