iKalyes/ChargingStation3.0/src/lvgl_group.h

#ifndef _LVGL_GROUP_H
#define _LVGL_GROUP_H

#include <lvgl.h>
#include <key.h>
#include "ui/ui.h"

void lvgl_group_init();
void lvgl_group_to_setting();
void lvgl_group_to_advancedsetting();
void lvgl_group_to_wifi();
void lvgl_group_to_main();
void lvgl_group_to_weather();

#endif
