iKalyes/ChargingStation3.0/(commit log)

2025-04-05 代码更新
2025-04-07 UI更新
2025-04-12 增加web上位机功能
2025-04-12 WEB页面添加黑暗模式
2025-04-12 修复手机显示
2025-04-14 拆分C口为C32控制和C1控制，修改UI和代码
2025-04-17 库文件更新及web界面优化
2025-04-17 修复从0设置休眠时间意外触发休眠的bug
2025-04-18 小BUG修复
2025-04-26 资源文件更新
    [中国城市代码表.csv, 前面板开孔.dxf, 后面板开孔.dxf, 多协议桌面充电站3.0上层BOM（价格估算）.xlsx, 多协议桌面充电站3.0下层BOM（价格估算）.xlsx]
2025-07-15 固件更新
